wjanssens/factotum/kicad/factotum/factotum.kicad_pcb

## KiCad design kicad/factotum/factotum.kicad_pcb (2021-01-31)

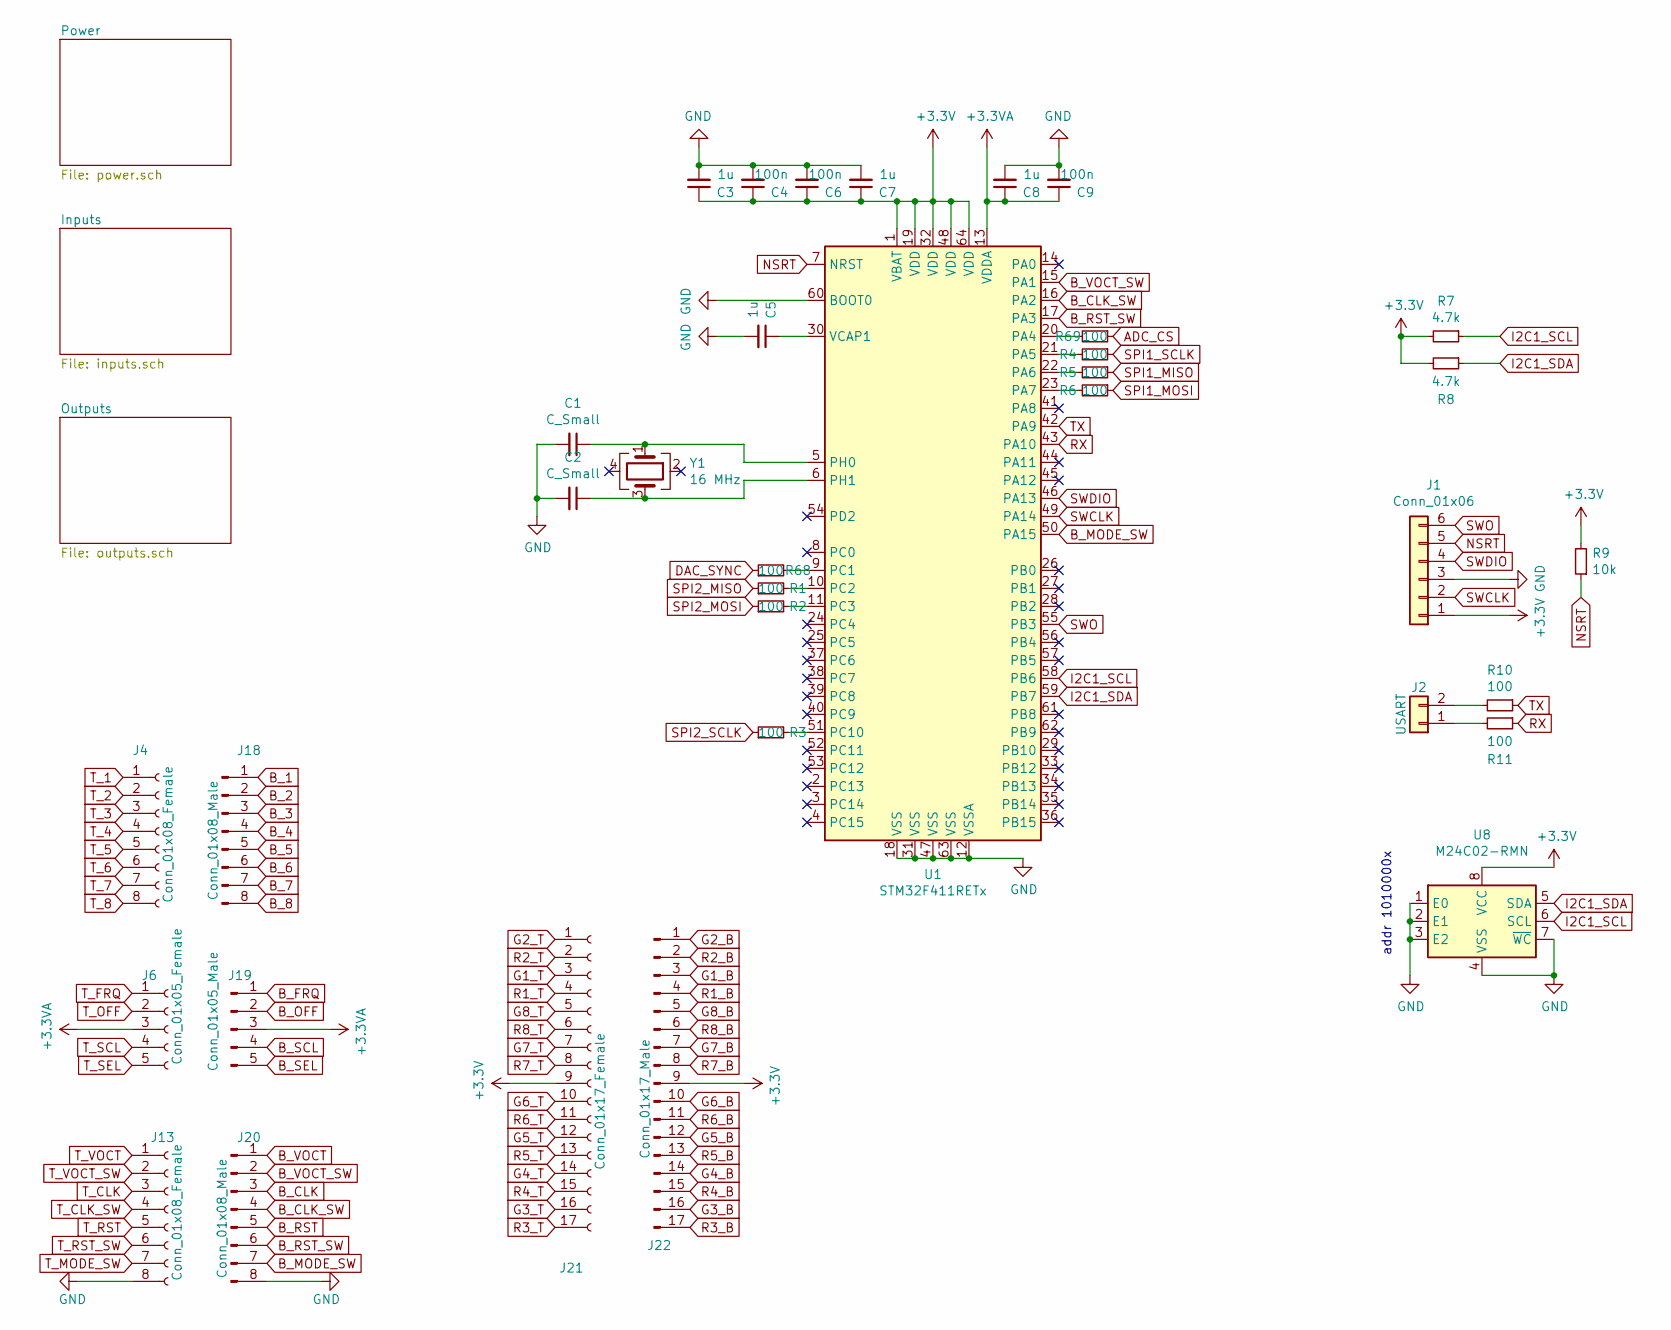
[picture p1: schematic factotum.sch]

Parts:
C1, C2: C_Small; C_0603_1608Metric_Pad1.08x0.95mm_HandSolder
C3, C5, C7, C8: 1u; C_0603_1608Metric_Pad1.08x0.95mm_HandSolder
C4, C6, C9: 100n; C_0603_1608Metric_Pad1.08x0.95mm_HandSolder
J1: Conn_01x06; PinHeader_1x06_P2.54mm_Vertical
J2: USART; PinHeader_1x02_P2.54mm_Vertical
J4, J13: Conn_01x08_Female; PinSocket_1x08_P2.54mm_Vertical
J6: Conn_01x05_Female; PinSocket_1x05_P2.54mm_Vertical
J18, J20: Conn_01x08_Male; PinHeader_1x08_P2.54mm_Vertical
J19: Conn_01x05_Male; PinHeader_1x05_P2.54mm_Vertical
J21: Conn_01x17_Female; PinSocket_1x17_P2.54mm_Vertical
J22: Conn_01x17_Male; PinHeader_1x17_P2.54mm_Vertical
R1, R2, R3, R4, R5, R6, R10, R11, R68, R69: 100; R_0603_1608Metric_Pad0.98x0.95mm_HandSolder
R7, R8: 4.7k; R_0603_1608Metric_Pad0.98x0.95mm_HandSolder
R9: 10k; R_0603_1608Metric_Pad0.98x0.95mm_HandSolder
U1: STM32F411RETx; LQFP-64_10x10mm_P0.5mm
U8: M24C02-RMN; SOIC-8_3.9x4.9mm_P1.27mm
Y1: 16 MHz; Crystal_SMD_0603-4Pin_6.0x3.5mm_HandSoldering

Connections:
+3.3VA: C8.1, C9.1, J6.3, J19.3, U1.13 (VDDA); also elsewhere on the board
+3V3: C3.1, C4.1, C6.1, C7.1, J1.1, J21.9, J22.9, R7.2, R8.2, R9.2, U1.1 (VBAT), U1.19 (VDD), U1.32 (VDD), U1.48 (VDD), U1.64 (VDD), U8.8 (VCC); also elsewhere on the board
ADC_CS: R69.1; also elsewhere on the board
B_1: J18.1; also elsewhere on the board
B_2: J18.2; also elsewhere on the board
B_3: J18.3; also elsewhere on the board
B_4: J18.4; also elsewhere on the board
B_5: J18.5; also elsewhere on the board
B_6: J18.6; also elsewhere on the board
B_7: J18.7; also elsewhere on the board
B_8: J18.8; also elsewhere on the board
B_CLK: J20.3; also elsewhere on the board
B_CLK_SW: J20.4, U1.16 (PA2); also elsewhere on the board
B_FRQ: J19.1; also elsewhere on the board
B_MODE_SW: J20.7, U1.50 (PA15)
B_OFF: J19.2; also elsewhere on the board
B_RST: J20.5; also elsewhere on the board
B_RST_SW: J20.6, U1.17 (PA3); also elsewhere on the board
B_SCL: J19.4; also elsewhere on the board
B_SEL: J19.5; also elsewhere on the board
B_VOCT: J20.1; also elsewhere on the board
B_VOCT_SW: J20.2, U1.15 (PA1); also elsewhere on the board
DAC_SYNC: R68.1; also elsewhere on the board
G1_B: J22.3; also elsewhere on the board
G1_T: J21.3; also elsewhere on the board
G2_B: J22.1; also elsewhere on the board
G2_T: J21.1; also elsewhere on the board
G3_B: J22.16; also elsewhere on the board
G3_T: J21.16; also elsewhere on the board
G4_B: J22.14; also elsewhere on the board
G4_T: J21.14; also elsewhere on the board
G5_B: J22.12; also elsewhere on the board
G5_T: J21.12; also elsewhere on the board
G6_B: J22.10; also elsewhere on the board
G6_T: J21.10; also elsewhere on the board
G7_B: J22.7; also elsewhere on the board
G7_T: J21.7; also elsewhere on the board
G8_B: J22.5; also elsewhere on the board
G8_T: J21.5; also elsewhere on the board
GND: C1.2, C2.2, C3.2, C4.2, C5.2, C6.2, C7.2, C8.2, C9.2, J1.3, J13.8, J20.8, U1.12 (VSSA), U1.18 (VSS), U1.31 (VSS), U1.47 (VSS), U1.60 (BOOT0), U1.63 (VSS), U8.1 (E0), U8.2 (E1), U8.3 (E2), U8.4 (VSS), U8.7 (~WC); also elsewhere on the board
I2C1_SCL: R7.1, U1.58 (PB6), U8.6 (SCL); also elsewhere on the board
I2C1_SDA: R8.1, U1.59 (PB7), U8.5 (SDA); also elsewhere on the board
NSRT: J1.5, R9.1, U1.7 (NRST)
unnamed: C1.1, U1.5 (PH0), Y1.1
unnamed: C2.1, U1.6 (PH1), Y1.3
unnamed: C5.1, U1.30 (VCAP1)
unnamed: J2.1, R11.2
unnamed: J2.2, R10.2
unnamed: R1.2, U1.10 (PC2)
unnamed: R2.2, U1.11 (PC3)
unnamed: R3.2, U1.51 (PC10)
unnamed: R4.2, U1.21 (PA5)
unnamed: R5.2, U1.22 (PA6)
unnamed: R6.2, U1.23 (PA7)
unnamed: R68.2, U1.9 (PC1)
unnamed: R69.2, U1.20 (PA4)
R1_B: J22.4; also elsewhere on the board
R1_T: J21.4; also elsewhere on the board
R2_B: J22.2; also elsewhere on the board
R2_T: J21.2; also elsewhere on the board
R3_B: J22.17; also elsewhere on the board
R3_T: J21.17; also elsewhere on the board
R4_B: J22.15; also elsewhere on the board
R4_T: J21.15; also elsewhere on the board
R5_B: J22.13; also elsewhere on the board
R5_T: J21.13; also elsewhere on the board
R6_B: J22.11; also elsewhere on the board
R6_T: J21.11; also elsewhere on the board
R7_B: J22.8; also elsewhere on the board
R7_T: J21.8; also elsewhere on the board
R8_B: J22.6; also elsewhere on the board
R8_T: J21.6; also elsewhere on the board
RX: R11.1, U1.43 (PA10)
SPI1_MISO: R5.1; also elsewhere on the board
SPI1_MOSI: R6.1; also elsewhere on the board
SPI1_SCLK: R4.1; also elsewhere on the board
SPI2_MISO: R1.1; also elsewhere on the board
SPI2_MOSI: R2.1; also elsewhere on the board
SPI2_SCLK: R3.1; also elsewhere on the board
SWCLK: J1.2, U1.49 (PA14)
SWDIO: J1.4, U1.46 (PA13)
SWO: J1.6, U1.55 (PB3)
TX: R10.1, U1.42 (PA9)
T_1: J4.1; also elsewhere on the board
T_2: J4.2; also elsewhere on the board
T_3: J4.3; also elsewhere on the board
T_4: J4.4; also elsewhere on the board
T_5: J4.5; also elsewhere on the board
T_6: J4.6; also elsewhere on the board
T_7: J4.7; also elsewhere on the board
T_8: J4.8; also elsewhere on the board
T_CLK: J13.3; also elsewhere on the board
T_CLK_SW: J13.4; also elsewhere on the board
T_FRQ: J6.1; also elsewhere on the board
T_MODE_SW: J13.7; also elsewhere on the board
T_OFF: J6.2; also elsewhere on the board
T_RST: J13.5; also elsewhere on the board
T_RST_SW: J13.6; also elsewhere on the board
T_SCL: J6.4; also elsewhere on the board
T_SEL: J6.5; also elsewhere on the board
T_VOCT: J13.1; also elsewhere on the board
T_VOCT_SW: J13.2; also elsewhere on the board

Notes on the sheet:
addr 1010000x

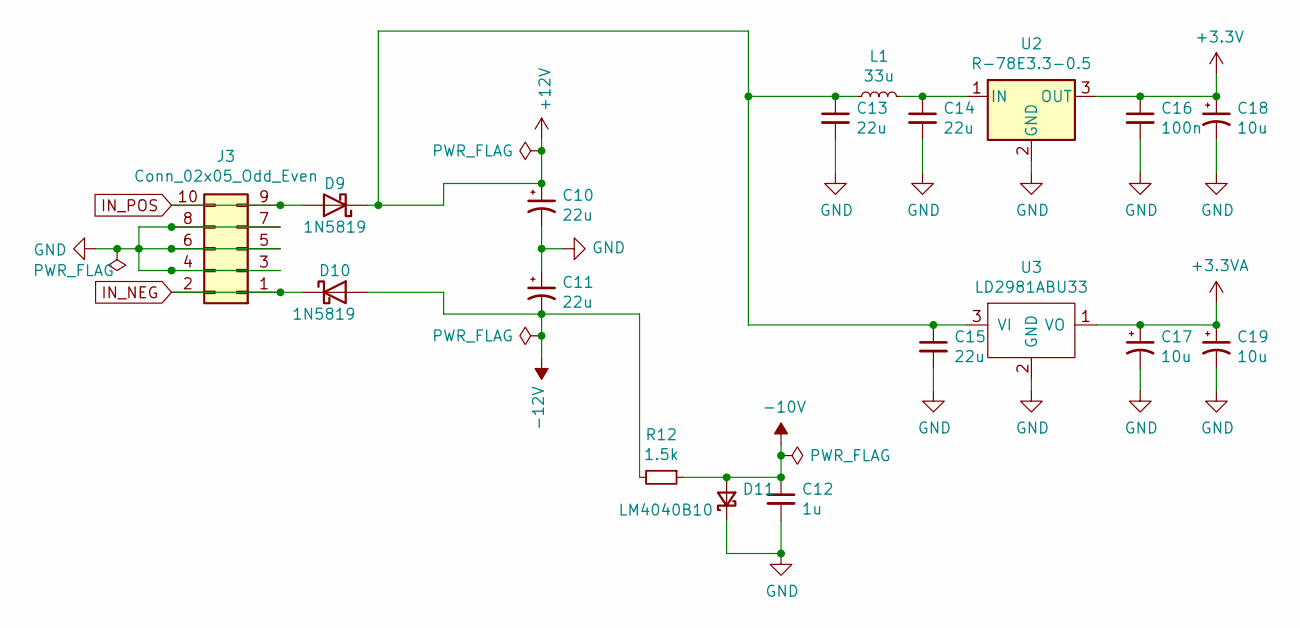
[picture p2: schematic power.sch]

Parts:
C10, C11, C13, C14, C15: 22u; C_0603_1608Metric_Pad1.08x0.95mm_HandSolder
C12: 1u; C_0603_1608Metric_Pad1.08x0.95mm_HandSolder
C16: 100n; C_0603_1608Metric_Pad1.08x0.95mm_HandSolder
C17, C18, C19: 10u; C_0603_1608Metric_Pad1.08x0.95mm_HandSolder
D9, D10: 1N5819; D_DO-41_SOD81_P10.16mm_Horizontal
D11: LM4040B10; SOT-23
J3: Conn_02x05_Odd_Even; PinHeader_2x05_P2.54mm_Vertical
L1: 33u; L_0603_1608Metric_Pad1.05x0.95mm_HandSolder
R12: 1.5k; R_0603_1608Metric_Pad0.98x0.95mm_HandSolder
U2: R-78E3.3-0.5; Converter_DCDC_RECOM_R-78E-0.5_THT
U3: LD2981ABU33; SOT-89-3

Connections:
+3.3VA: C17.1, C19.1, U3.1 (VO); also elsewhere on the board
+3V3: C16.1, C18.1, U2.3 (OUT); also elsewhere on the board
+12V: C10.1, C13.1, C15.1, D9.1 (K), L1.1, U3.3 (VI)
-10V: C12.1, D11.2 (A), R12.1; also elsewhere on the board
-12V: C11.2, D10.2 (A), R12.2
GND: C10.2, C11.1, C12.2, C13.2, C14.2, C15.2, C16.2, C17.2, C18.2, C19.2, D11.1 (K), J3.3, J3.4, J3.5, J3.6, J3.7, J3.8, U2.2 (GND), U3.2 (GND); also elsewhere on the board
IN_NEG: D10.1 (K), J3.1, J3.2
IN_POS: D9.2 (A), J3.9, J3.10
unnamed: C14.1, L1.2, U2.1 (IN)

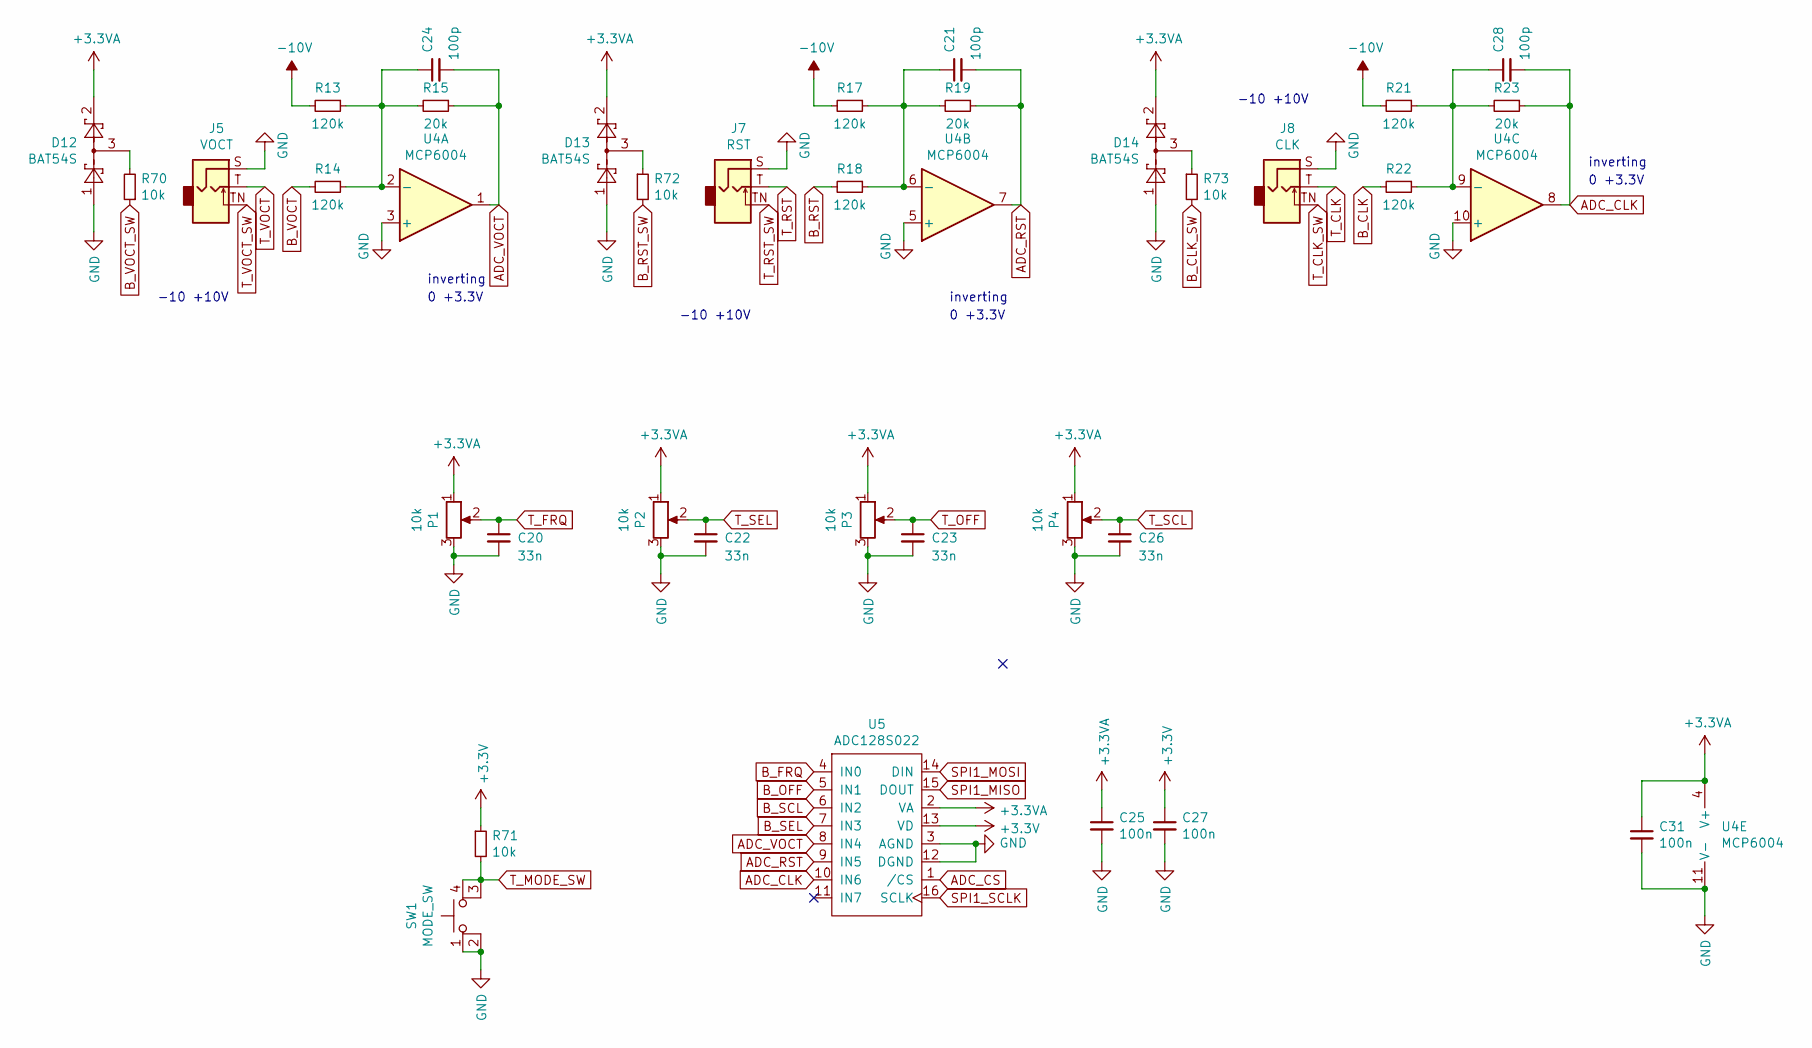
[picture p3: schematic inputs.sch]

Parts:
C20, C22, C23, C26: 33n; C_0603_1608Metric_Pad1.08x0.95mm_HandSolder
C21, C24, C28: 100p; C_0603_1608Metric_Pad1.08x0.95mm_HandSolder
C25, C27, C31: 100n; C_0603_1608Metric_Pad1.08x0.95mm_HandSolder
D12, D13, D14: BAT54S; SOT-23
J5: VOCT; Jack_3.5mm_QingPu_WQP-PJ398SM_Vertical_CircularHoles
J7: RST; Jack_3.5mm_QingPu_WQP-PJ398SM_Vertical_CircularHoles
J8: CLK; Jack_3.5mm_QingPu_WQP-PJ398SM_Vertical_CircularHoles
P1, P2, P3, P4: 10k; Potentiometer_Alpha_RD901F-40-00D_Single_Vertical_CircularH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
R13, R14, R17, R18, R21, R22: 120k; R_0603_1608Metric_Pad0.98x0.95mm_HandSolder
R15, R19, R23: 20k; R_0603_1608Metric_Pad0.98x0.95mm_HandSolder
R70, R71, R72, R73: 10k; R_0603_1608Metric_Pad0.98x0.95mm_HandSolder
SW1: MODE_SW; SW_TH_Tactile_Omron_B3F-10xx
U4: MCP6004; TSSOP-14_4.4x5mm_P0.65mm
U5: ADC128S022; TSSOP-16_4.4x5mm_P0.65mm

Connections:
+3.3VA: C25.1, C31.1, D12.2, D13.2, D14.2, P1.1, P2.1, P3.1, P4.1, U4.4 (V+), U5.2 (VA); also elsewhere on the board
+3V3: C27.1, R71.1, U5.13 (VD); also elsewhere on the board
-10V: R13.2, R17.2, R21.2; also elsewhere on the board
ADC_CLK: C28.2, R23.1, U4.8, U5.10 (IN6)
ADC_CS: U5.1 (/CS); also elsewhere on the board
ADC_RST: C21.2, R19.1, U4.7, U5.9 (IN5)
ADC_VOCT: C24.2, R15.1, U4.1, U5.8 (IN4)
B_CLK: R22.2; also elsewhere on the board
B_CLK_SW: R73.2; also elsewhere on the board
B_FRQ: U5.4 (IN0); also elsewhere on the board
B_OFF: U5.5 (IN1); also elsewhere on the board
B_RST: R18.2; also elsewhere on the board
B_RST_SW: R72.2; also elsewhere on the board
B_SCL: U5.6 (IN2); also elsewhere on the board
B_SEL: U5.7 (IN3); also elsewhere on the board
B_VOCT: R14.2; also elsewhere on the board
B_VOCT_SW: R70.1; also elsewhere on the board
GND: C20.2, C22.2, C23.2, C25.2, C26.2, C27.2, C31.2, D12.1, D13.1, D14.1, J5.S, J7.S, J8.S, P1.3, P2.3, P3.3, P4.3, SW1.1, SW1.2, U4.3 (+), U4.5 (+), U4.10 (+), U4.11 (V-), U5.3 (AGND), U5.12 (DGND); also elsewhere on the board
unnamed: C21.1, R17.1, R18.1, R19.2, U4.6 (-)
unnamed: C24.1, R13.1, R14.1, R15.2, U4.2 (-)
unnamed: C28.1, R21.1, R22.1, R23.2, U4.9 (-)
unnamed: D12.3, R70.2
unnamed: D13.3, R72.1
unnamed: D14.3, R73.1
SPI1_MISO: U5.15 (DOUT); also elsewhere on the board
SPI1_MOSI: U5.14 (DIN); also elsewhere on the board
SPI1_SCLK: U5.16 (SCLK); also elsewhere on the board
T_CLK: J8.T; also elsewhere on the board
T_CLK_SW: J8.TN; also elsewhere on the board
T_FRQ: C20.1, P1.2; also elsewhere on the board
T_MODE_SW: R71.2, SW1.3 (K), SW1.4 (A); also elsewhere on the board
T_OFF: C23.1, P3.2; also elsewhere on the board
T_RST: J7.T; also elsewhere on the board
T_RST_SW: J7.TN; also elsewhere on the board
T_SCL: C26.1, P4.2; also elsewhere on the board
T_SEL: C22.1, P2.2; also elsewhere on the board
T_VOCT: J5.T; also elsewhere on the board
T_VOCT_SW: J5.TN; also elsewhere on the board

Notes on the sheet:
inverting
0 +3.3V
-10 +10V

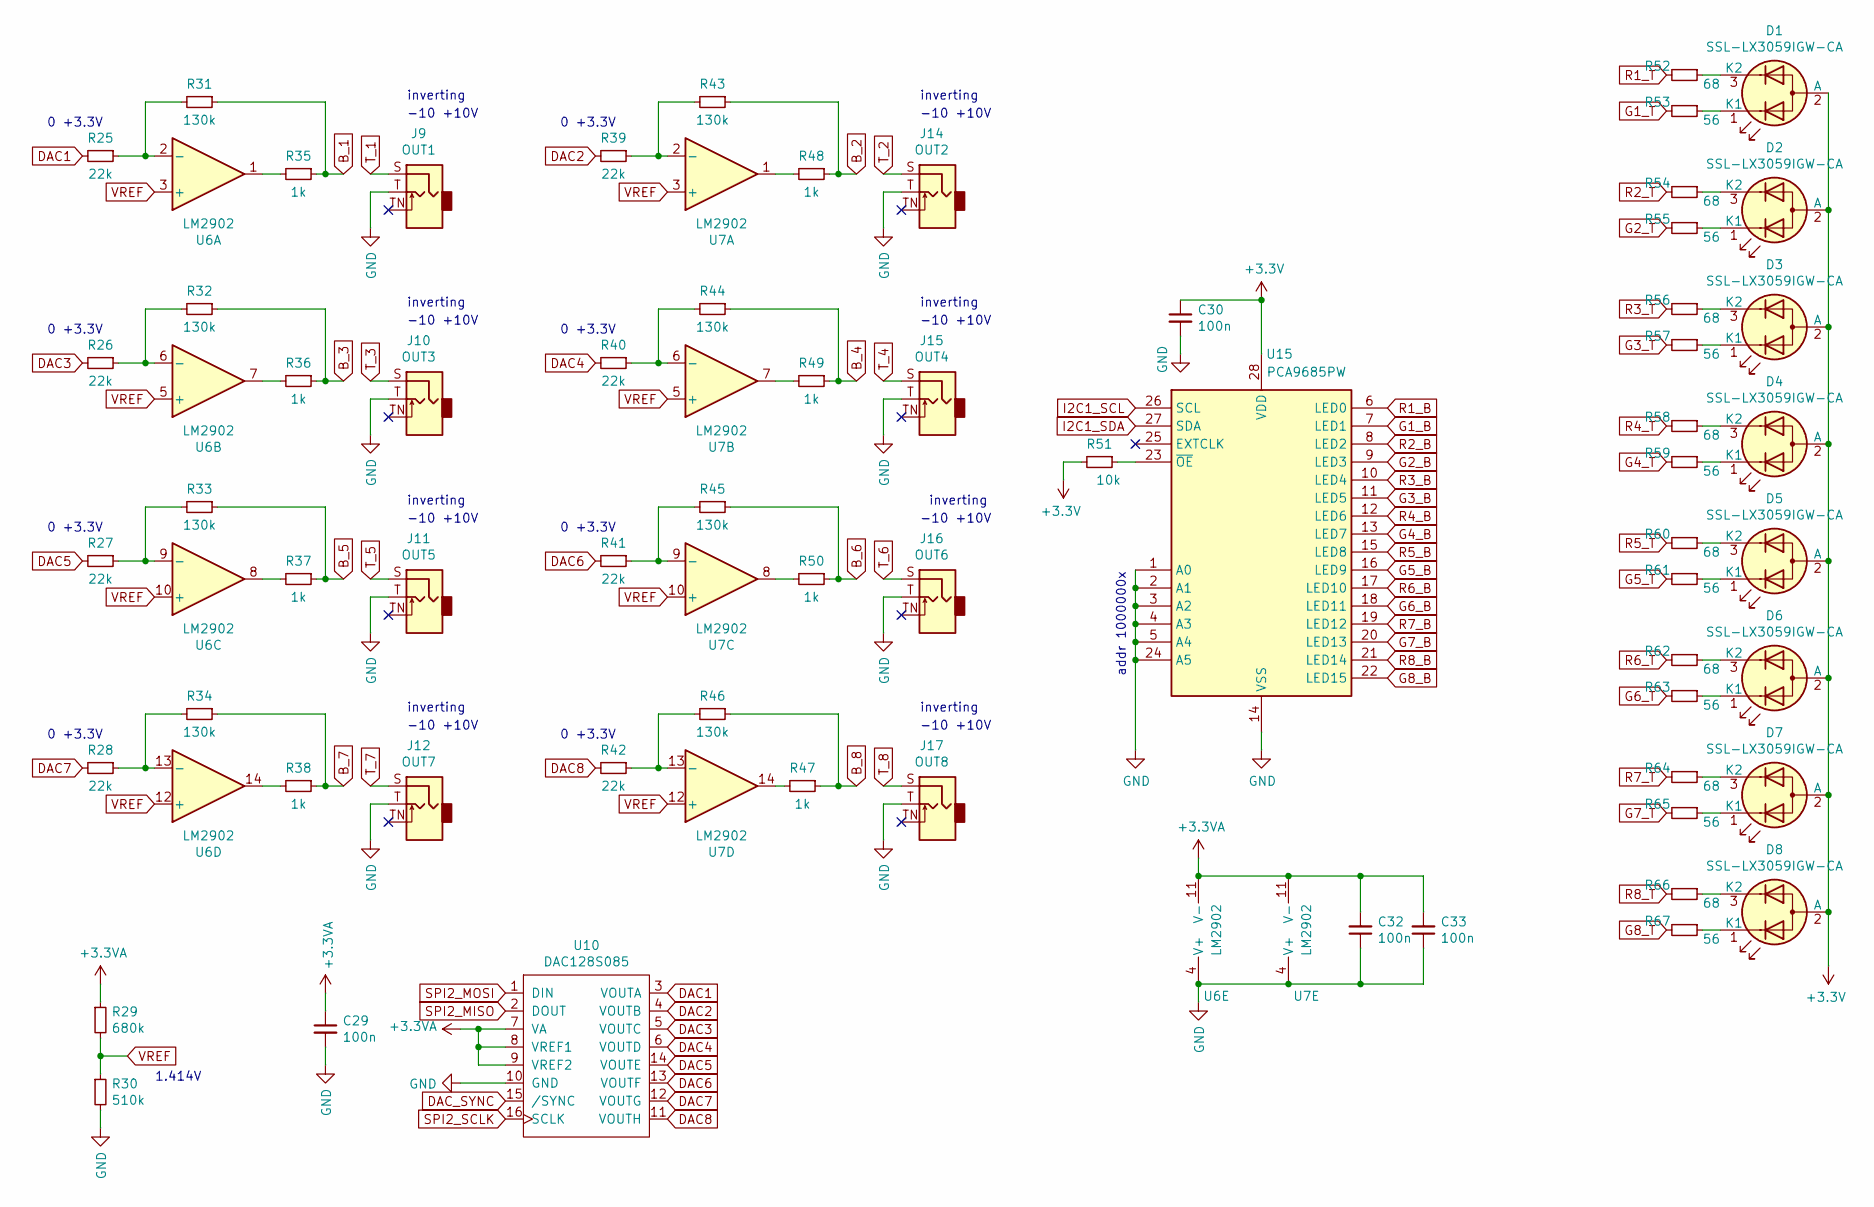
[picture p4: schematic outputs.sch]

Parts:
C29, C30, C32, C33: 100n; C_0603_1608Metric_Pad1.08x0.95mm_HandSolder
D1, D2, D3, D4, D5, D6, D7, D8: SSL-LX3059IGW-CA; LED_D3.0mm-3
J9: OUT1; Jack_3.5mm_QingPu_WQP-PJ398SM_Vertical_CircularHoles
J10: OUT3; Jack_3.5mm_QingPu_WQP-PJ398SM_Vertical_CircularHoles
J11: OUT5; Jack_3.5mm_QingPu_WQP-PJ398SM_Vertical_CircularHoles
J12: OUT7; Jack_3.5mm_QingPu_WQP-PJ398SM_Vertical_CircularHoles
J14: OUT2; Jack_3.5mm_QingPu_WQP-PJ398SM_Vertical_CircularHoles
J15: OUT4; Jack_3.5mm_QingPu_WQP-PJ398SM_Vertical_CircularHoles
J16: OUT6; Jack_3.5mm_QingPu_WQP-PJ398SM_Vertical_CircularHoles
J17: OUT8; Jack_3.5mm_QingPu_WQP-PJ398SM_Vertical_CircularHoles
R25, R26, R27, R28, R39, R40, R41, R42: 22k; R_0603_1608Metric_Pad0.98x0.95mm_HandSolder
R29: 680k; R_0603_1608Metric_Pad0.98x0.95mm_HandSolder
R30: 510k; R_0603_1608Metric_Pad0.98x0.95mm_HandSolder
R31, R32, R33, R34, R43, R44, R45, R46: 130k; R_0603_1608Metric_Pad0.98x0.95mm_HandSolder
R35, R36, R37, R38, R47, R48, R49, R50: 1k; R_0603_1608Metric_Pad0.98x0.95mm_HandSolder
R51: 10k; R_0603_1608Metric_Pad0.98x0.95mm_HandSolder
R52, R54, R56, R58, R60, R62, R64, R66: 68; R_0603_1608Metric_Pad0.98x0.95mm_HandSolder
R53, R55, R57, R59, R61, R63, R65, R67: 56; R_0603_1608Metric_Pad0.98x0.95mm_HandSolder
U6, U7: LM2902; TSSOP-14_4.4x5mm_P0.65mm
U10: DAC128S085; TSSOP-16_4.4x5mm_P0.65mm
U15: PCA9685PW; TSSOP-28_4.4x9.7mm_P0.65mm

Connections:
+3.3VA: C29.1, C32.2, C33.2, R29.1, U6.11 (V-), U7.11 (V-), U10.7 (VA), U10.8 (VREF1), U10.9 (VREF2); also elsewhere on the board
+3V3: C30.1, D1.2 (A), D2.2 (A), D3.2 (A), D4.2 (A), D5.2 (A), D6.2 (A), D7.2 (A), D8.2 (A), R51.2, U15.28 (VDD); also elsewhere on the board
B_1: R31.1, R35.1; also elsewhere on the board
B_2: R43.1, R48.1; also elsewhere on the board
B_3: R32.1, R36.1; also elsewhere on the board
B_4: R44.1, R49.1; also elsewhere on the board
B_5: R33.1, R37.1; also elsewhere on the board
B_6: R45.1, R50.1; also elsewhere on the board
B_7: R34.1, R38.1; also elsewhere on the board
B_8: R46.1, R47.1; also elsewhere on the board
DAC1: R25.2, U10.3 (VOUTA)
DAC2: R39.2, U10.4 (VOUTB)
DAC3: R26.2, U10.5 (VOUTC)
DAC4: R40.2, U10.6 (VOUTD)
DAC5: R27.2, U10.14 (VOUTE)
DAC6: R41.2, U10.13 (VOUTF)
DAC7: R28.2, U10.12 (VOUTG)
DAC8: R42.2, U10.11 (VOUTH)
DAC_SYNC: U10.15 (/SYNC); also elsewhere on the board
G1_B: U15.7 (LED1); also elsewhere on the board
G1_T: R53.2; also elsewhere on the board
G2_B: U15.9 (LED3); also elsewhere on the board
G2_T: R55.2; also elsewhere on the board
G3_B: U15.11 (LED5); also elsewhere on the board
G3_T: R57.2; also elsewhere on the board
G4_B: U15.13 (LED7); also elsewhere on the board
G4_T: R59.2; also elsewhere on the board
G5_B: U15.16 (LED9); also elsewhere on the board
G5_T: R61.2; also elsewhere on the board
G6_B: U15.18 (LED11); also elsewhere on the board
G6_T: R63.2; also elsewhere on the board
G7_B: U15.20 (LED13); also elsewhere on the board
G7_T: R65.2; also elsewhere on the board
G8_B: U15.22 (LED15); also elsewhere on the board
G8_T: R67.2; also elsewhere on the board
GND: C29.2, C30.2, C32.1, C33.1, J9.T, J10.T, J11.T, J12.T, J14.T, J15.T, J16.T, J17.T, R30.2, U6.4 (V+), U7.4 (V+), U10.10 (GND), U15.1 (A0), U15.2 (A1), U15.3 (A2), U15.4 (A3), U15.5 (A4), U15.14 (VSS), U15.24 (A5); also elsewhere on the board
I2C1_SCL: U15.26 (SCL); also elsewhere on the board
I2C1_SDA: U15.27 (SDA); also elsewhere on the board
unnamed: D1.1 (K1), R53.1
unnamed: D1.3 (K2), R52.1
unnamed: D2.1 (K1), R55.1
unnamed: D2.3 (K2), R54.1
unnamed: D3.1 (K1), R57.1
unnamed: D3.3 (K2), R56.1
unnamed: D4.1 (K1), R59.1
unnamed: D4.3 (K2), R58.1
unnamed: D5.1 (K1), R61.1
unnamed: D5.3 (K2), R60.1
unnamed: D6.1 (K1), R63.1
unnamed: D6.3 (K2), R62.1
unnamed: D7.1 (K1), R65.1
unnamed: D7.3 (K2), R64.1
unnamed: D8.1 (K1), R67.1
unnamed: D8.3 (K2), R66.1
unnamed: R25.1, R31.2, U6.2 (-)
unnamed: R26.1, R32.2, U6.6 (-)
unnamed: R27.1, R33.2, U6.9 (-)
unnamed: R28.1, R34.2, U6.13 (-)
unnamed: R35.2, U6.1
unnamed: R36.2, U6.7
unnamed: R37.2, U6.8
unnamed: R38.2, U6.14
unnamed: R39.1, R43.2, U7.2 (-)
unnamed: R40.1, R44.2, U7.6 (-)
unnamed: R41.1, R45.2, U7.9 (-)
unnamed: R42.1, R46.2, U7.13 (-)
unnamed: R47.2, U7.14
unnamed: R48.2, U7.1
unnamed: R49.2, U7.7
unnamed: R50.2, U7.8
unnamed: R51.1, U15.23 (~OE)
R1_B: U15.6 (LED0); also elsewhere on the board
R1_T: R52.2; also elsewhere on the board
R2_B: U15.8 (LED2); also elsewhere on the board
R2_T: R54.2; also elsewhere on the board
R3_B: U15.10 (LED4); also elsewhere on the board
R3_T: R56.2; also elsewhere on the board
R4_B: U15.12 (LED6); also elsewhere on the board
R4_T: R58.2; also elsewhere on the board
R5_B: U15.15 (LED8); also elsewhere on the board
R5_T: R60.2; also elsewhere on the board
R6_B: U15.17 (LED10); also elsewhere on the board
R6_T: R62.2; also elsewhere on the board
R7_B: U15.19 (LED12); also elsewhere on the board
R7_T: R64.2; also elsewhere on the board
R8_B: U15.21 (LED14); also elsewhere on the board
R8_T: R66.2; also elsewhere on the board
SPI2_MISO: U10.2 (DOUT); also elsewhere on the board
SPI2_MOSI: U10.1 (DIN); also elsewhere on the board
SPI2_SCLK: U10.16 (SCLK); also elsewhere on the board
T_1: J9.S; also elsewhere on the board
T_2: J14.S; also elsewhere on the board
T_3: J10.S; also elsewhere on the board
T_4: J15.S; also elsewhere on the board
T_5: J11.S; also elsewhere on the board
T_6: J16.S; also elsewhere on the board
T_7: J12.S; also elsewhere on the board
T_8: J17.S; also elsewhere on the board
VREF: R29.2, R30.1, U6.3 (+), U6.5 (+), U6.10 (+), U6.12 (+), U7.3 (+), U7.5 (+), U7.10 (+), U7.12 (+)

Notes on the sheet:
0 +3.3V
-10 +10V
inverting
1.414V
addr 1000000x

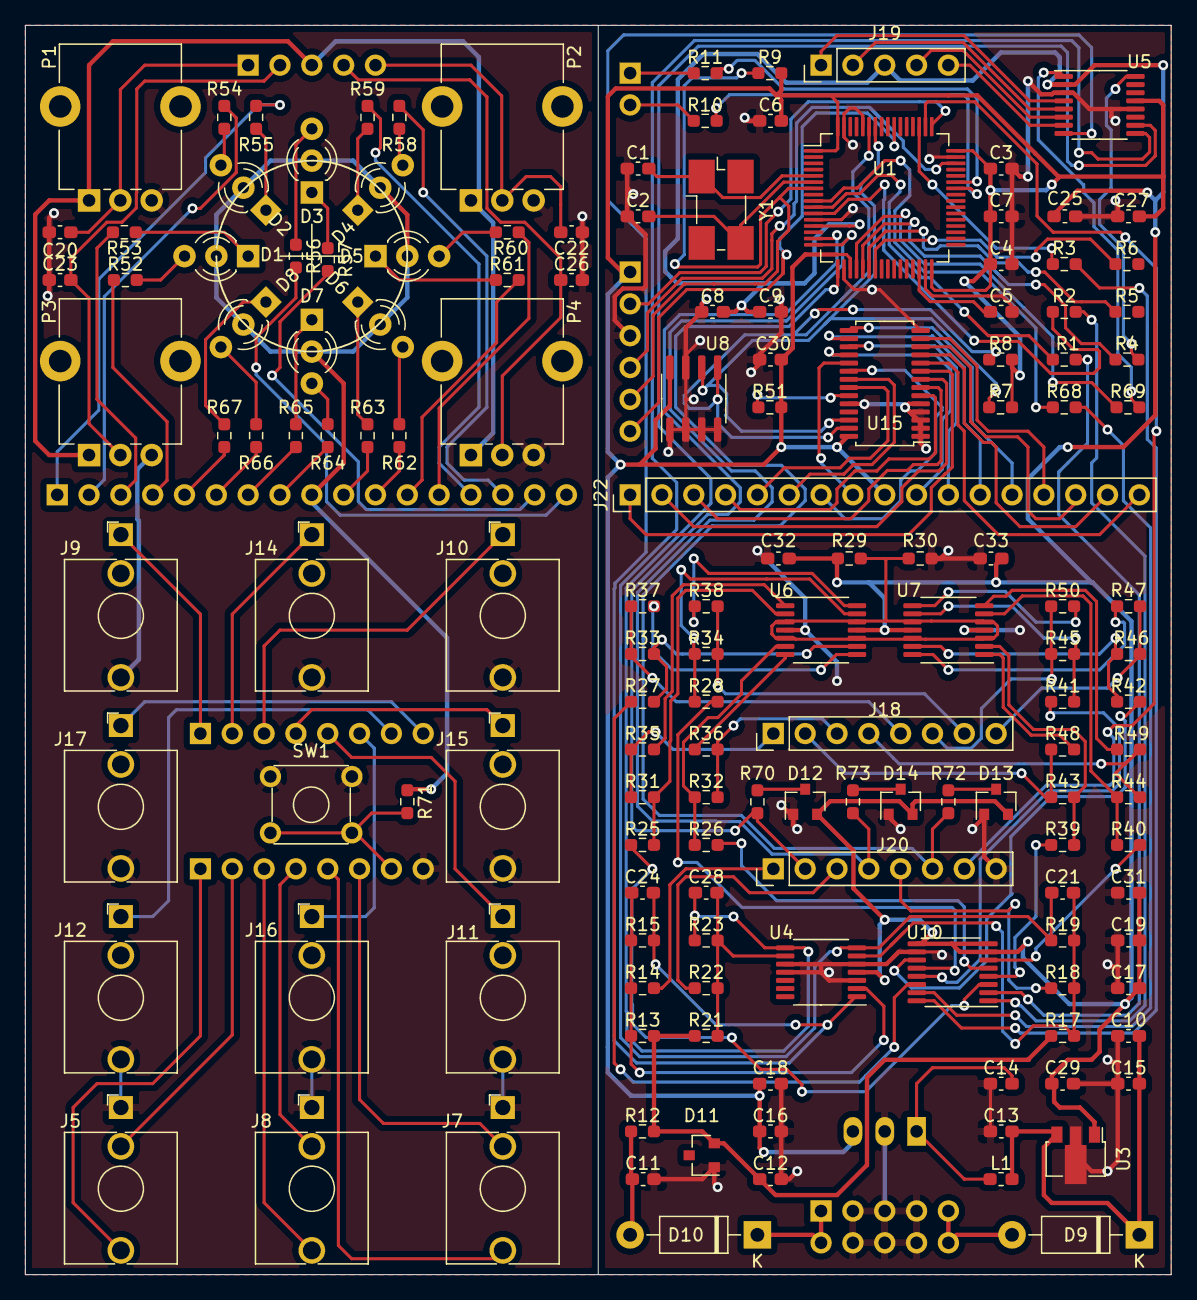
[picture p5: board factotum.kicad_pcb from above]

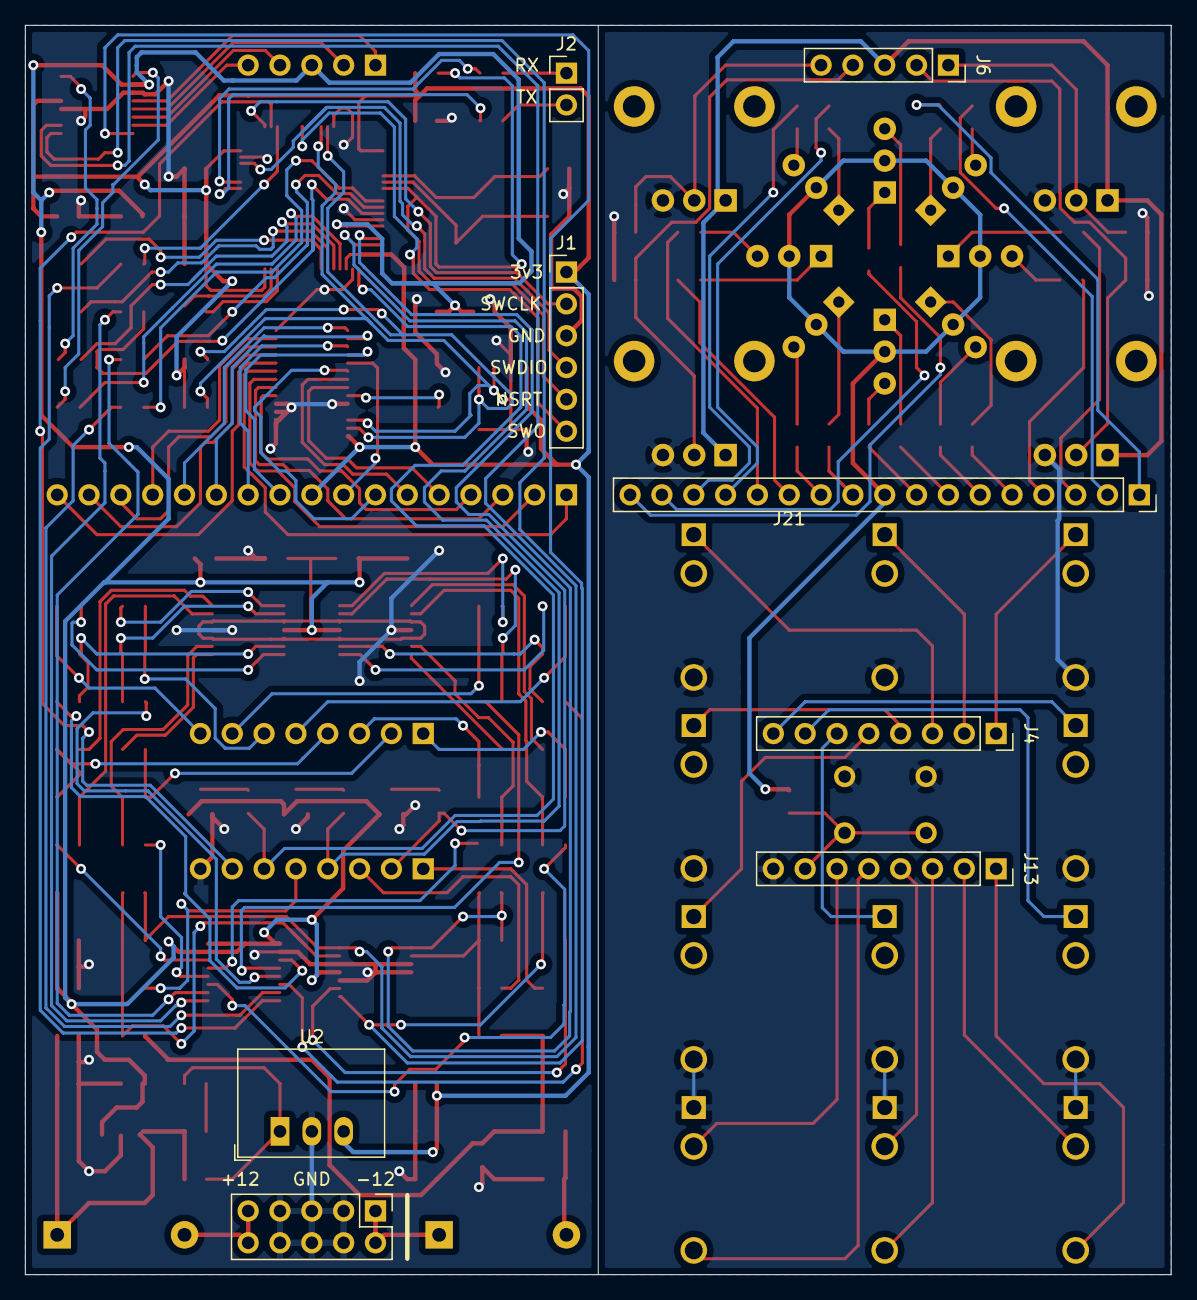
[picture p6: board factotum.kicad_pcb from below]

Board: 2 copper layers, 91.4 x 99.7 mm, 156 parts (8 on the bottom side), 159 nets.
