wjanssens/factotum/cubemx/cubemx.ioc

Mcu.UserName=STM32F411RETx
PC2.Signal=SPI2_MISO
PA9.Signal=USART1_TX
PB6.Signal=I2C1_SCL
PC3.Signal=SPI2_MOSI
PB10.Signal=SPI2_SCK
PA5.Signal=SPI1_SCK
PB7.Signal=I2C1_SDA
PA6.Signal=SPI1_MISO
PA10.Signal=USART1_RX
PA7.Signal=SPI1_MOSI
