wjanssens/factotum/(commit log)

2020-11-24 fixing mouting holes
2020-11-24 layout components so they fit on a 100mm x 45mm pcb
2020-11-29 working on schematic
    [factotum.sch, inputs.sch, outputs.sch, power.sch]
2020-11-29 initial layout of top board
    [factotum.kicad_pcb, factotum.sch, outputs.sch, power.sch]
2020-11-29 small move
    [factotum.kicad_pcb]
2020-12-06 inital board layout done but not routed
    [factotum.kicad_pcb, factotum.sch, inputs.sch, outputs.sch, power.sch]
2020-12-13 adding switches to inputs; fixing resistor components to 603
    [factotum.kicad_pcb, factotum.sch, inputs.sch, outputs.sch, power.sch]
2020-12-14 layout components again
    [factotum.kicad_pcb, power.sch]
2021-01-28 working on pcd routing
    [factotum.kicad_pcb, power.sch]
2021-01-30 more work on routing
    [factotum.kicad_pcb, factotum.sch, inputs.sch, outputs.sch, power.sch]
2021-01-31 finished routing
    [factotum.kicad_pcb, factotum.sch]
